PinBus/high-voltage_driver_board/plots/pdf/high-voltage_driver_V1.0-F.SilkS.pdf

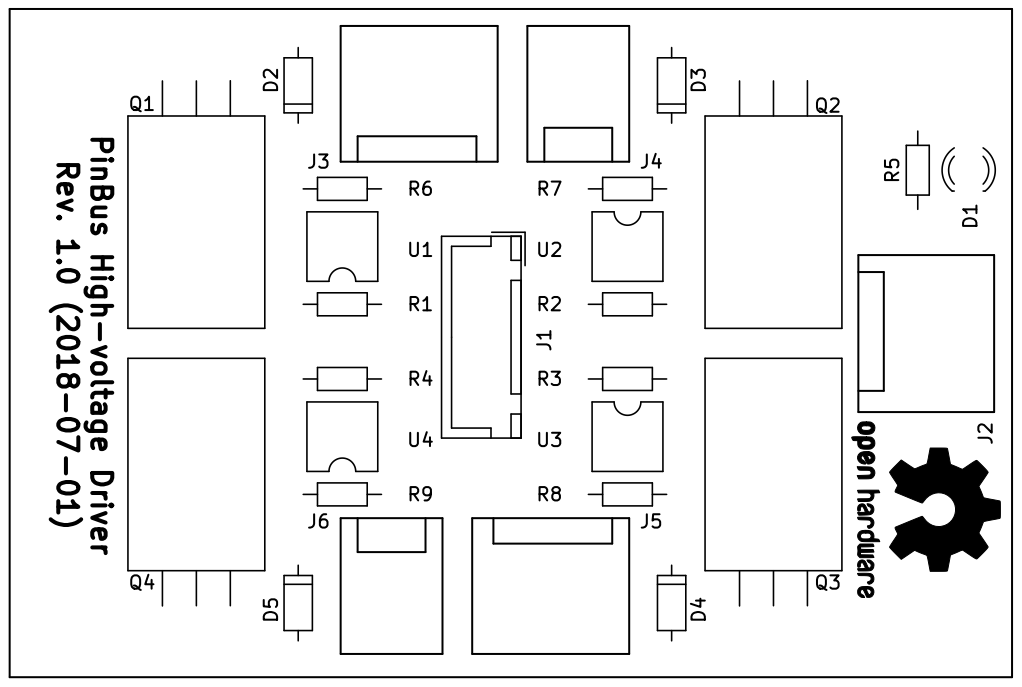
[picture p2: page 1]

Rev. 1.0 (2018-07-01) PinBus High-voltage Driver R8 D1 J1 J2
