PinBus/high-voltage_driver_board/plots/pdf/high-voltage_driver_V1.0.pdf

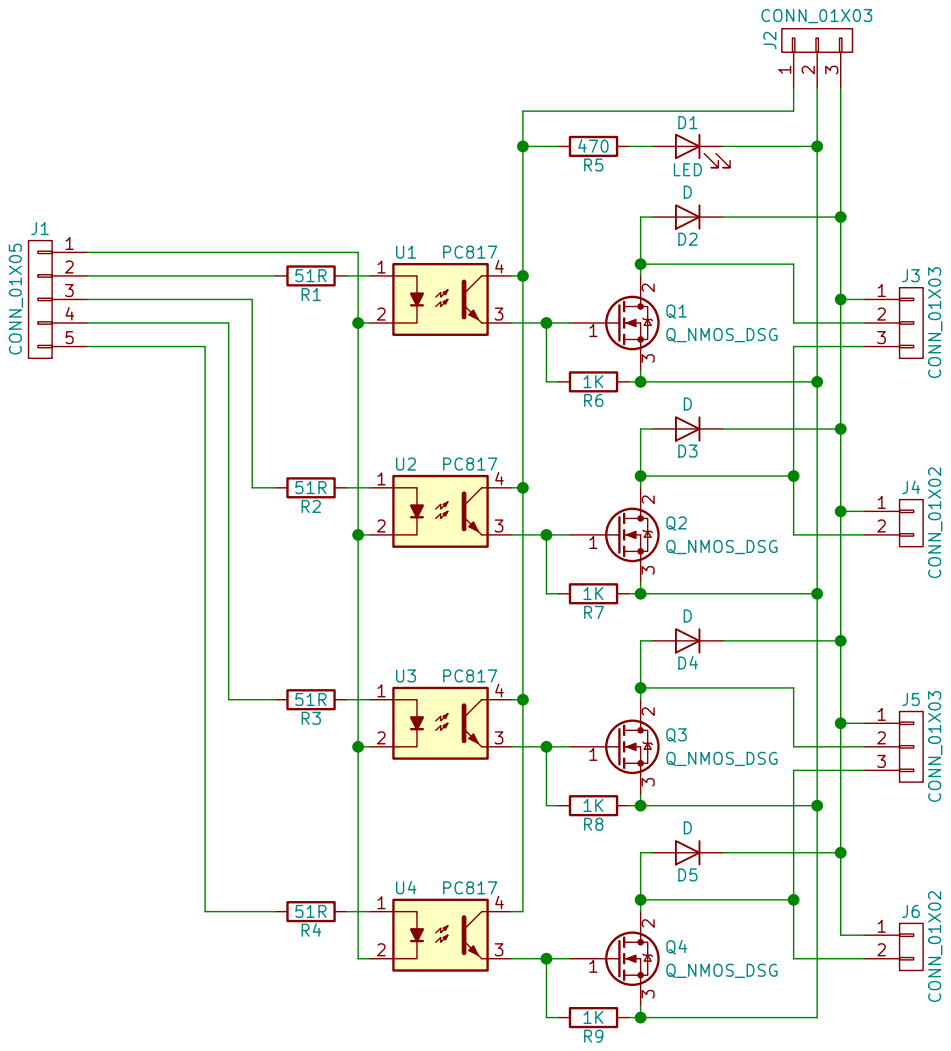
[picture p3: page 1]

Id: 1/1 Title: Pinbus High-voltage Driver
