PinBus/high-voltage_driver_board/plots/pdf/high-voltage_driver_V1.0-B.Cu.pdf

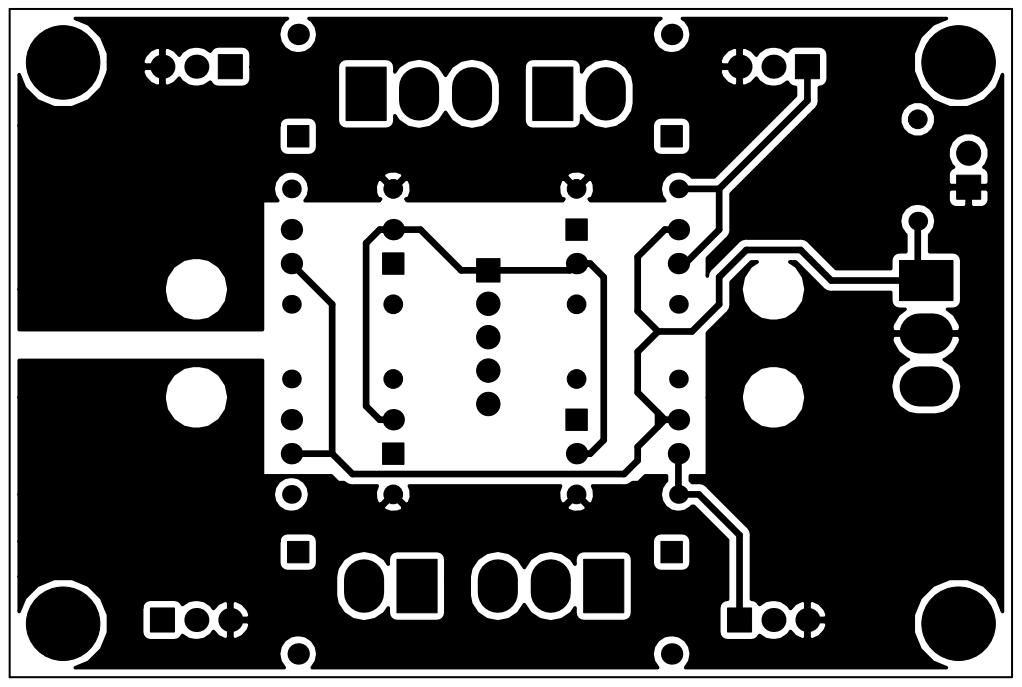
[picture p4: page 1]
