PinBus/high-voltage_driver_board/plots/pdf/high-voltage_driver_V1.0-B.Mask.pdf

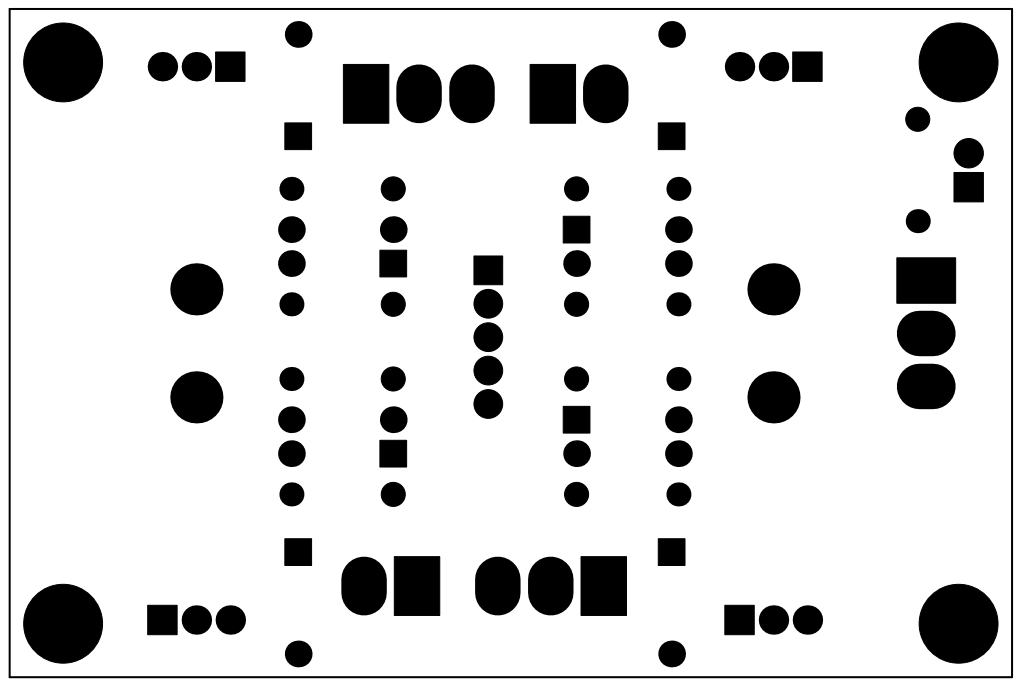
[picture p5: page 1]
