PinBus/high-voltage_driver_board/plots/pdf/high-voltage_driver_V1.0-F.Cu.pdf

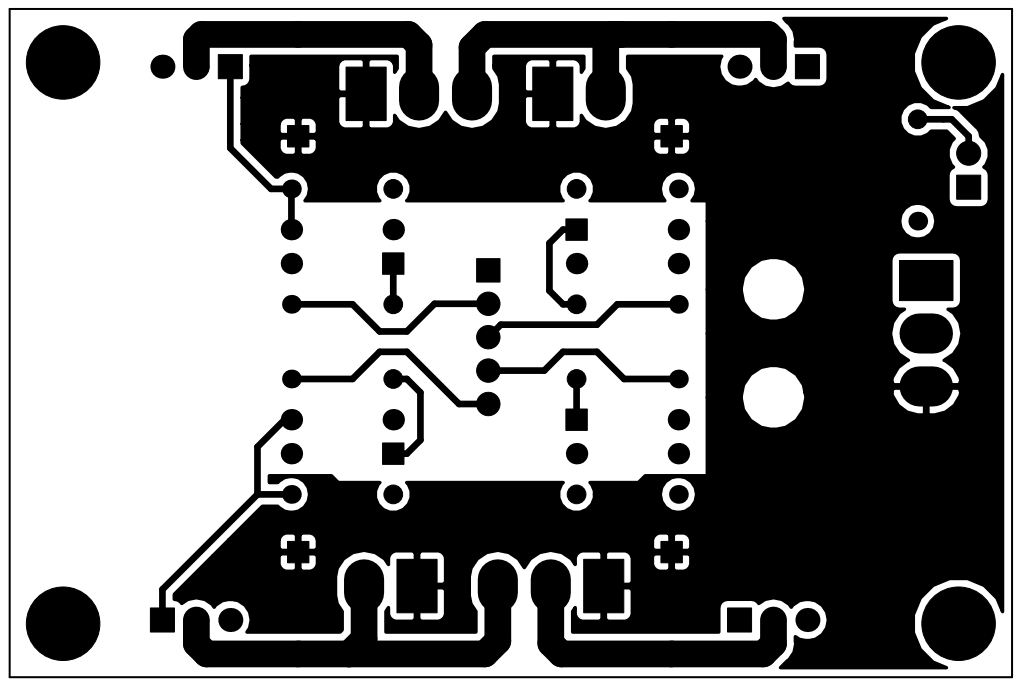
[picture p6: page 1]
