PinBus/high-voltage_driver_board/high-voltage_driver_V1.0.kicad_pcb

## KiCad design high-voltage_driver_V1.0.kicad_pcb (2018-12-14)

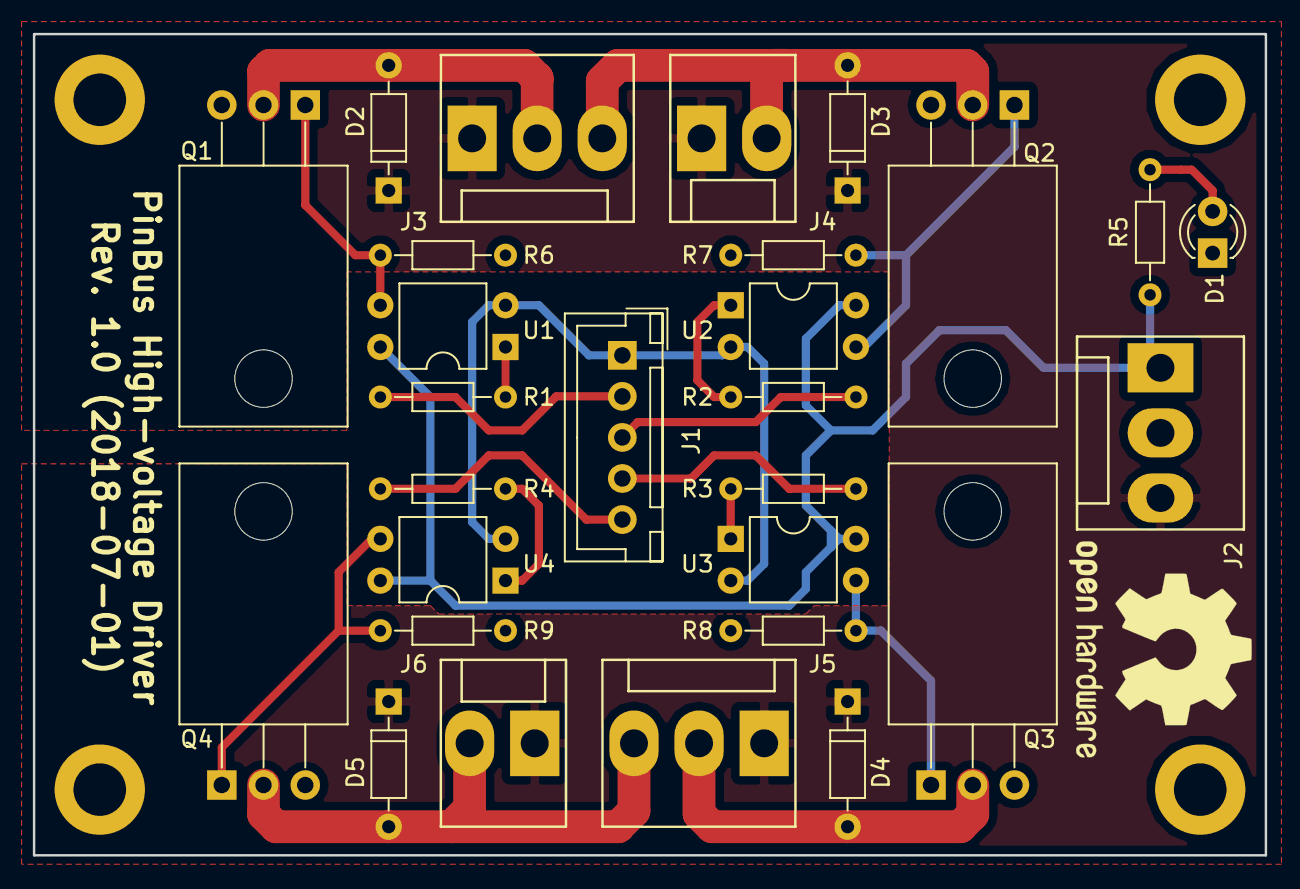
[picture p7: board high-voltage_driver_V1.0.kicad_pcb from above]

Board: 2 copper layers, 75.0 x 50.0 mm, 28 parts (0 on the bottom side), 21 nets.

Parts:
D1: LED; LED_D3.0mm
D2, D3, D4, D5: D; D_DO-35_SOD27_P7.62mm_Horizontal
J1: CONN_01X05; JST_XH_B05B-XH-A_05x2.50mm_Straight
J2, J3, J5: CONN_01X03; Molex_KK-41791-03_03x3.96mm_Straight
J4, J6: CONN_01X02; Molex_KK-41791-02_02x3.96mm_Straight
Q1, Q2, Q3, Q4: Q_NMOS_DSG; TO-220-3_Horizontal
R1, R2, R3, R4: 51R; R_Axial_DIN0204_L3.6mm_D1.6mm_P7.62mm_Horizontal
R5: 470; R_Axial_DIN0204_L3.6mm_D1.6mm_P7.62mm_Horizontal
R6, R7, R8, R9: 1K; R_Axial_DIN0204_L3.6mm_D1.6mm_P7.62mm_Horizontal
U1, U2, U3, U4: PC817; DIP-4_W7.62mm

Connections:
unnamed: D1.1, J2.2, Q1.3, Q2.3, Q3.3, Q4.3, R6.1, R7.1, R8.1, R9.1
unnamed: D1.2, R5.1
unnamed: D2.1, D3.1, D4.1, D5.1, J2.3, J3.1, J4.1, J5.1, J6.1
unnamed: D2.2, J3.2, Q1.2
unnamed: D3.2, J3.3, J4.2, Q2.2
unnamed: D4.2, J5.2, Q3.2
unnamed: D5.2, J5.3, J6.2, Q4.2
unnamed: J1.1, U1.2, U2.2, U3.2, U4.2
unnamed: J1.2, R1.2
unnamed: J1.3, R2.2
unnamed: J1.4, R3.2
unnamed: J1.5, R4.2
unnamed: J2.1, R5.2, U1.4, U2.4, U3.4, U4.4
unnamed: Q1.1, R6.2, U1.3
unnamed: Q2.1, R7.2, U2.3
unnamed: Q3.1, R8.2, U3.3
unnamed: Q4.1, R9.2, U4.3
unnamed: R1.1, U1.1
unnamed: R2.1, U2.1
unnamed: R3.1, U3.1
unnamed: R4.1, U4.1
